shouta-31/WRO-Tezukayama-Lemon/flow_chart/Flowchart 8.PNG

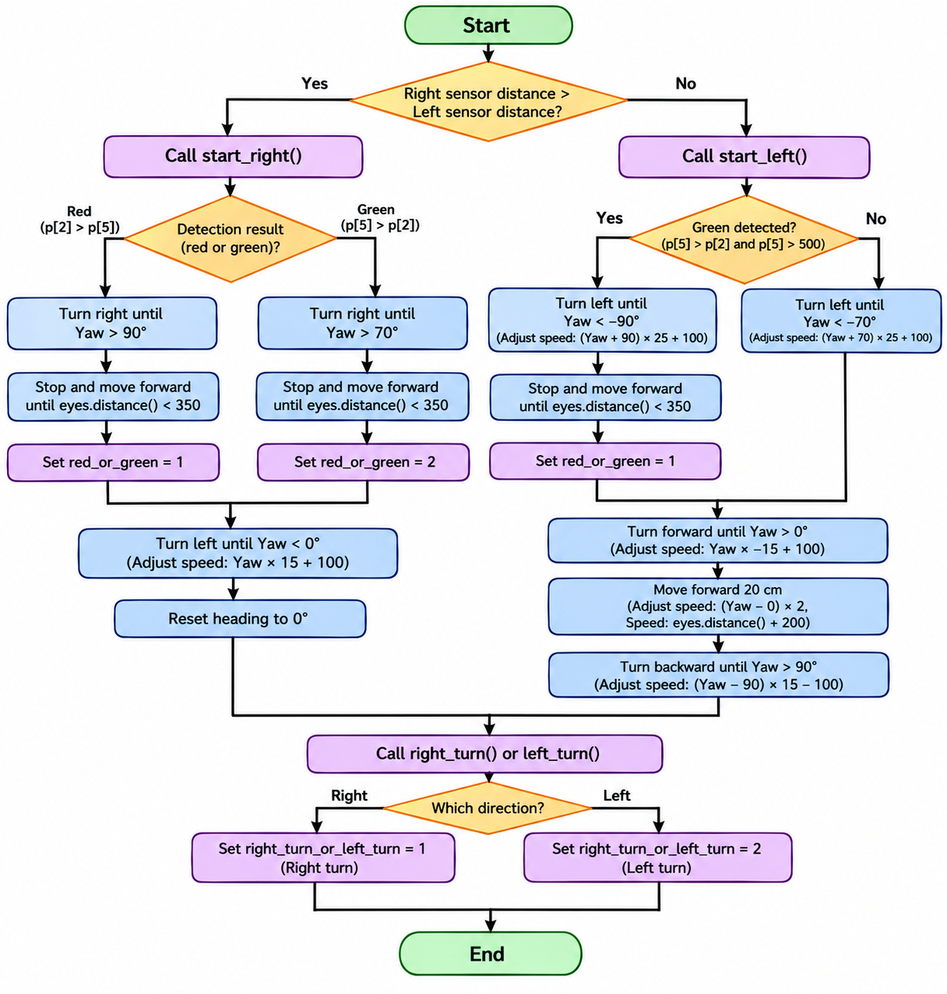
flow_chart/Flowchart 8.PNG
