shouta-31/WRO-Tezukayama-Lemon/flow_chart/Flowchart 7.PNG

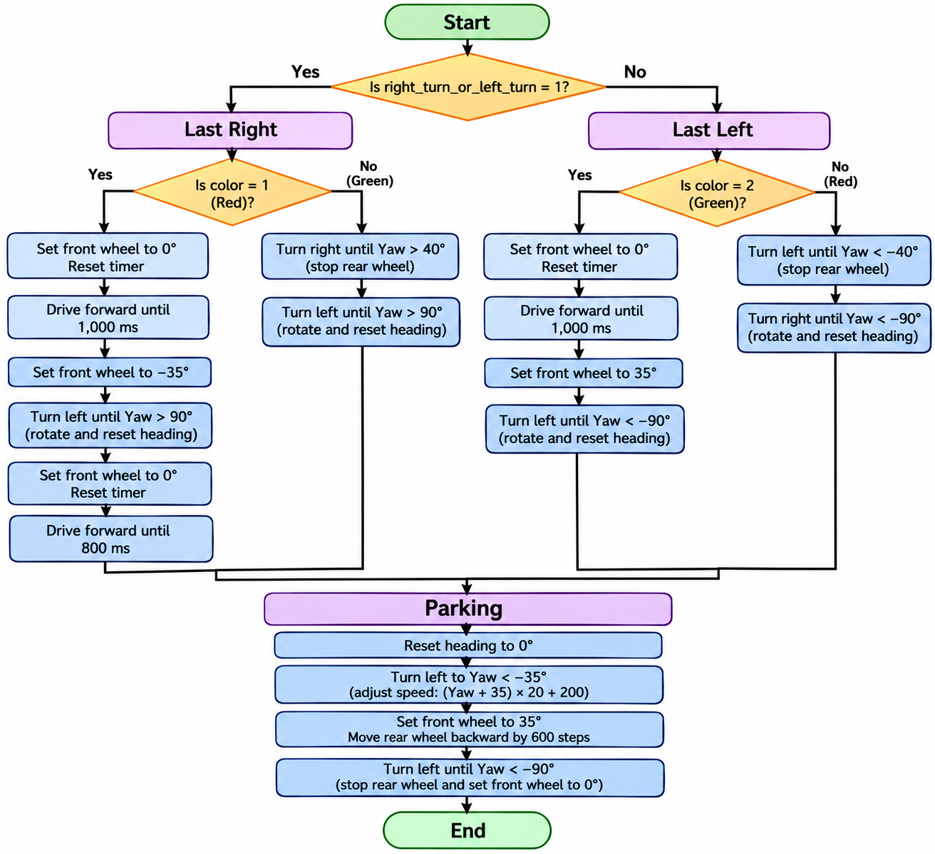
flow_chart/Flowchart 7.PNG
