shouta-31/WRO-Tezukayama-Lemon/flow_chart/readme.md

ロボット制御プログラムのフローチャート

flowchart_english_no_n

flowchart_english

ロボット駐車制御フローチャート

緑色障害物回避ロボット制御フロー図

赤色障害物回避フローチャート

ロボット制御ルーチンのフローチャート

ロボット旋回判断フローチャート
