shouta-31/WRO-Tezukayama-Lemon/schemes/Schematic.md

# Electromechanical diagrams 
## Overall Robot Circuit Diagram


## SPIKE Prime Hub Circuit Diagram


## OpenMV H7 Plus Circuit Diagram


## OpenMV H7 Plus OV5640 Circuit Diagram 
