shouta-31/WRO-Tezukayama-Lemon/t-photos/team's-photos.md

# Team's photos

## Funny Photo


## Official Photo
