shouta-31/WRO-Tezukayama-Lemon/v-photos/vehicle's-photos.md

# Vehicle's photos
## Front


## Rear side


## Left side


## Right side


## Top surface


## Bottom surface
