shouta-31/WRO-Tezukayama-Lemon/source/program.md

Control software
====
[Open rounds.pdf](https://github.com/user-attachments/files/30932936/Open.rounds.pdf)
[Open MV.pdf](https://github.com/user-attachments/files/30932932/Open.MV.pdf)
[Obstacle rounds.pdf](https://github.com/user-attachments/files/30932923/Obstacle.rounds.pdf)
