shouta-31/WRO-Tezukayama-Lemon/schemes/無題のドキュメント 2.pdf

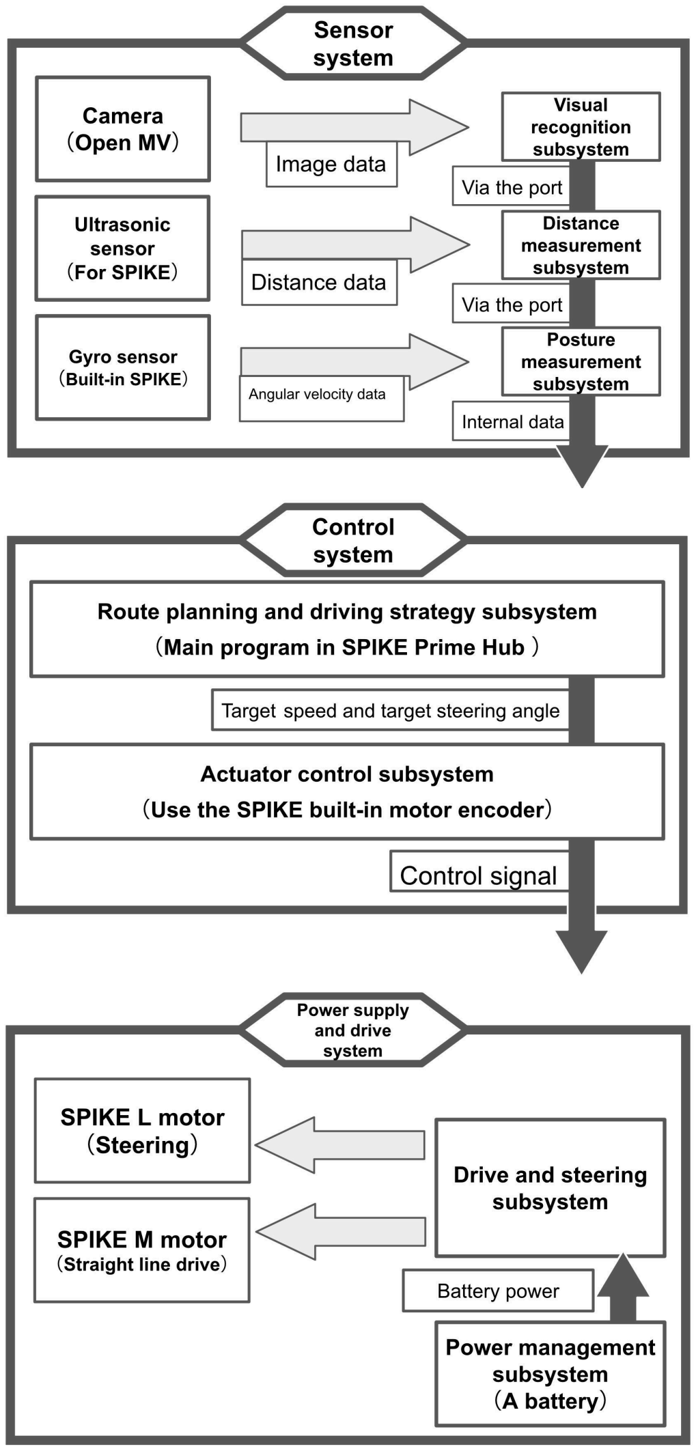
[picture p3: page 1]
