shouta-31/WRO-Tezukayama-Lemon/flow_chart/Flowchart 1.PNG

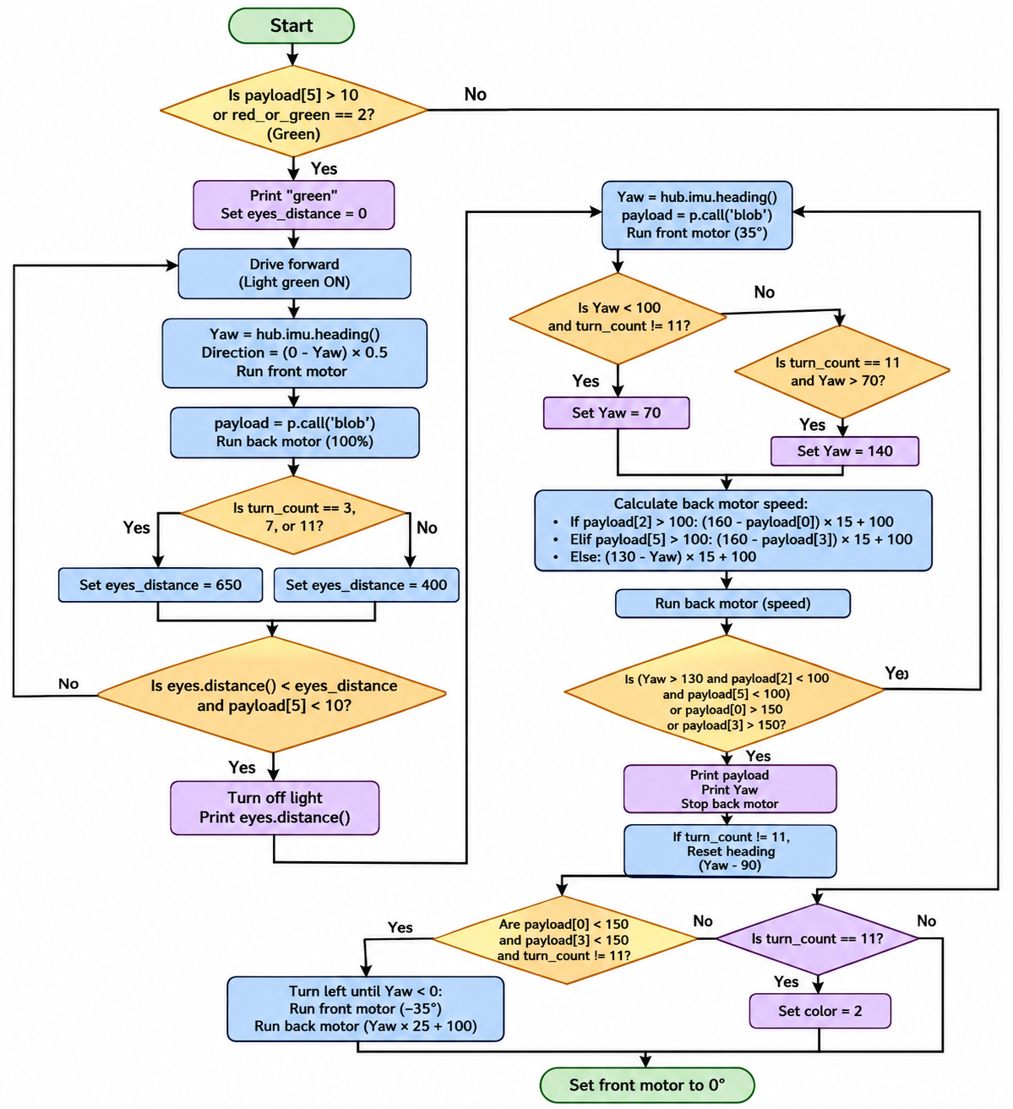
flow_chart/Flowchart 1.PNG
