shouta-31/WRO-Tezukayama-Lemon/flow_chart/Flowchart 2.PNG

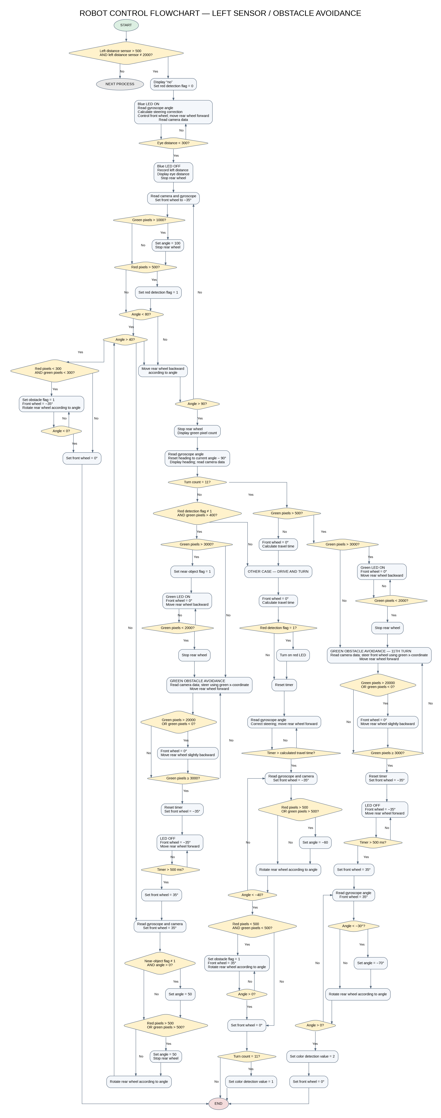
flow_chart/Flowchart 2.PNG
