shouta-31/WRO-Tezukayama-Lemon/flow_chart/Flowchart 3.PNG

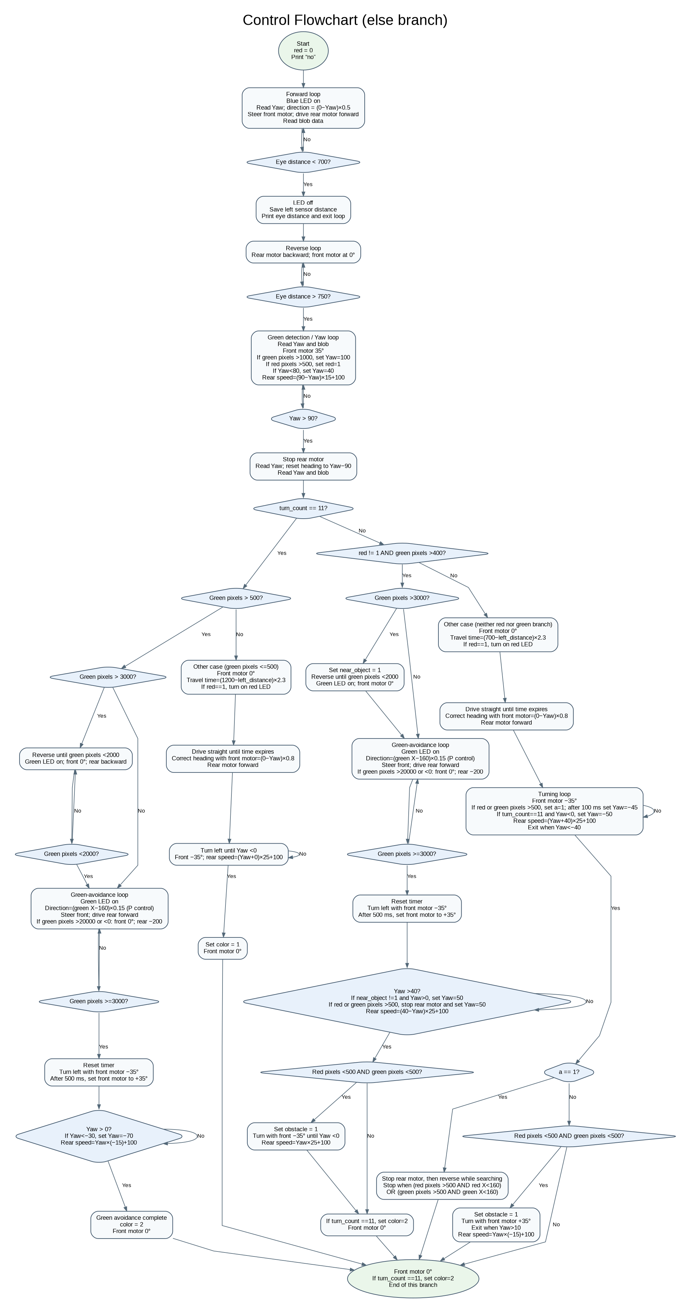
flow_chart/Flowchart 3.PNG
