shouta-31/WRO-Tezukayama-Lemon/flow_chart/Flowchart 4.PNG

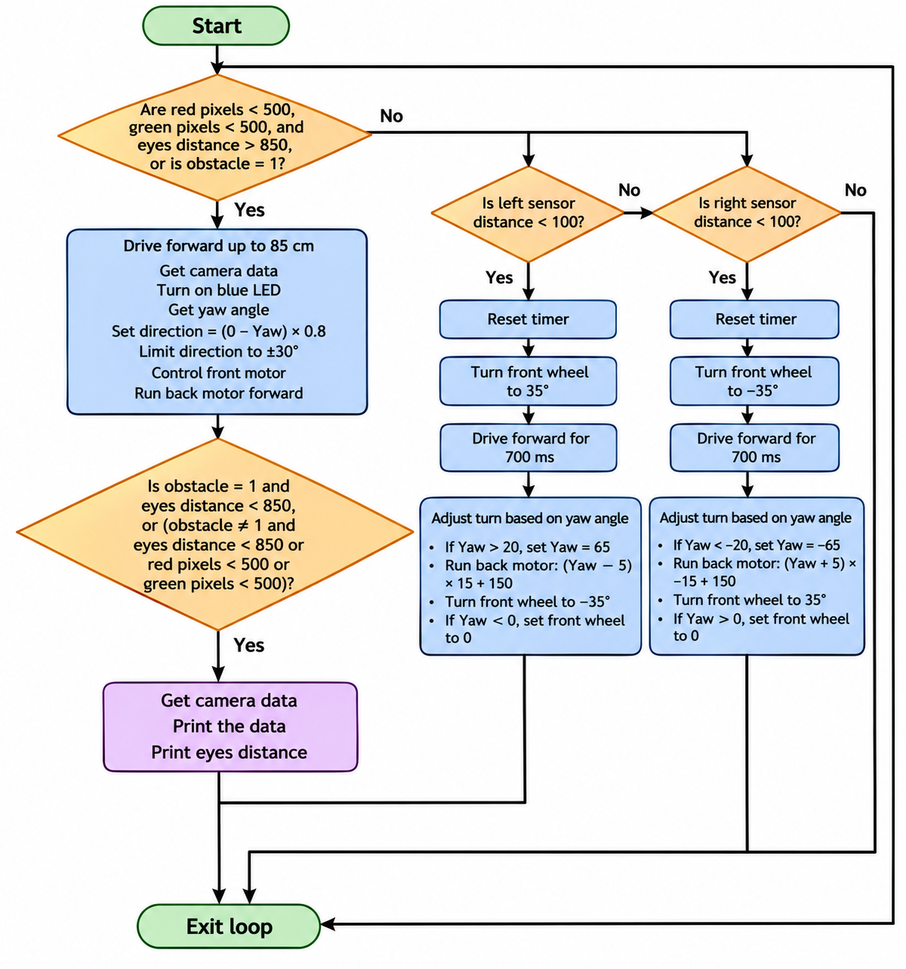
flow_chart/Flowchart 4.PNG
