shouta-31/WRO-Tezukayama-Lemon/flow_chart/Flowchart 5.PNG

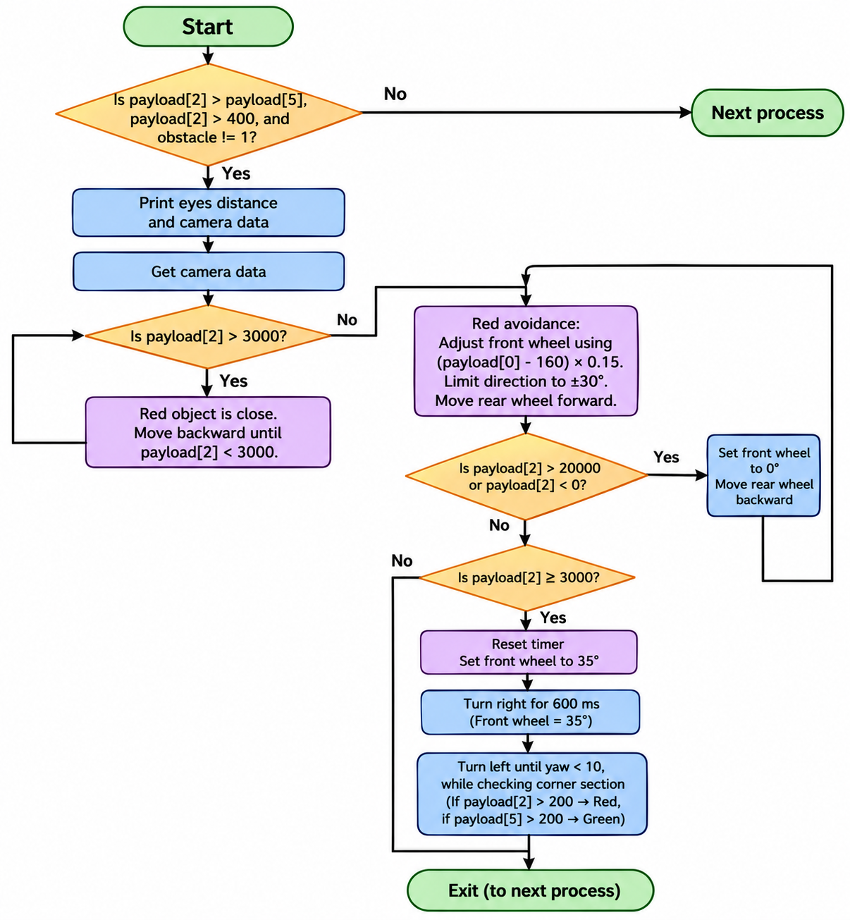
flow_chart/Flowchart 5.PNG
