shouta-31/WRO-Tezukayama-Lemon/flow_chart/Flowchart 6.PNG

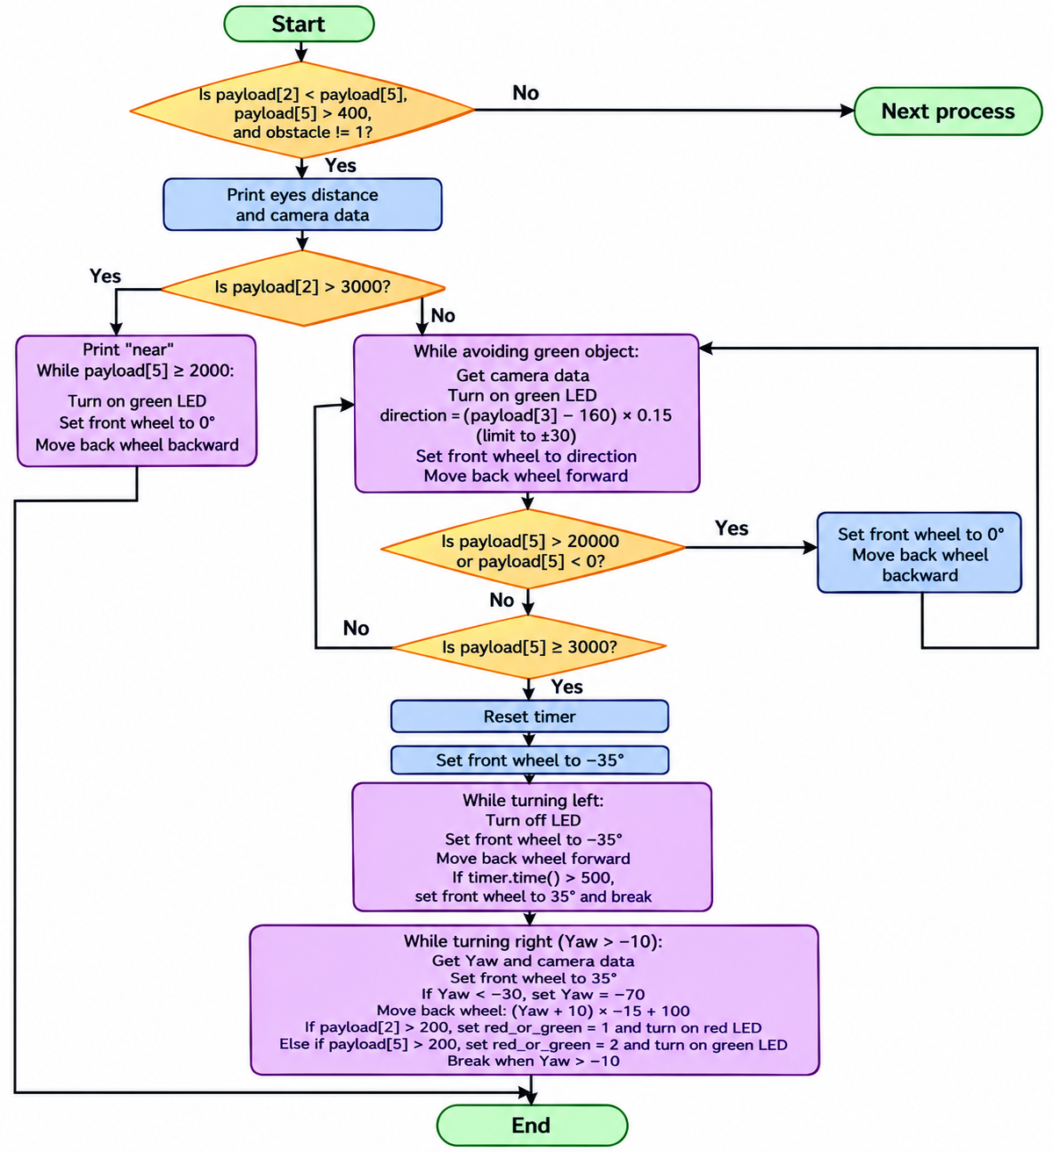
flow_chart/Flowchart 6.PNG
