shouta-31/WRO-Tezukayama-Lemon/models/OpenMV H7 Plus.stl

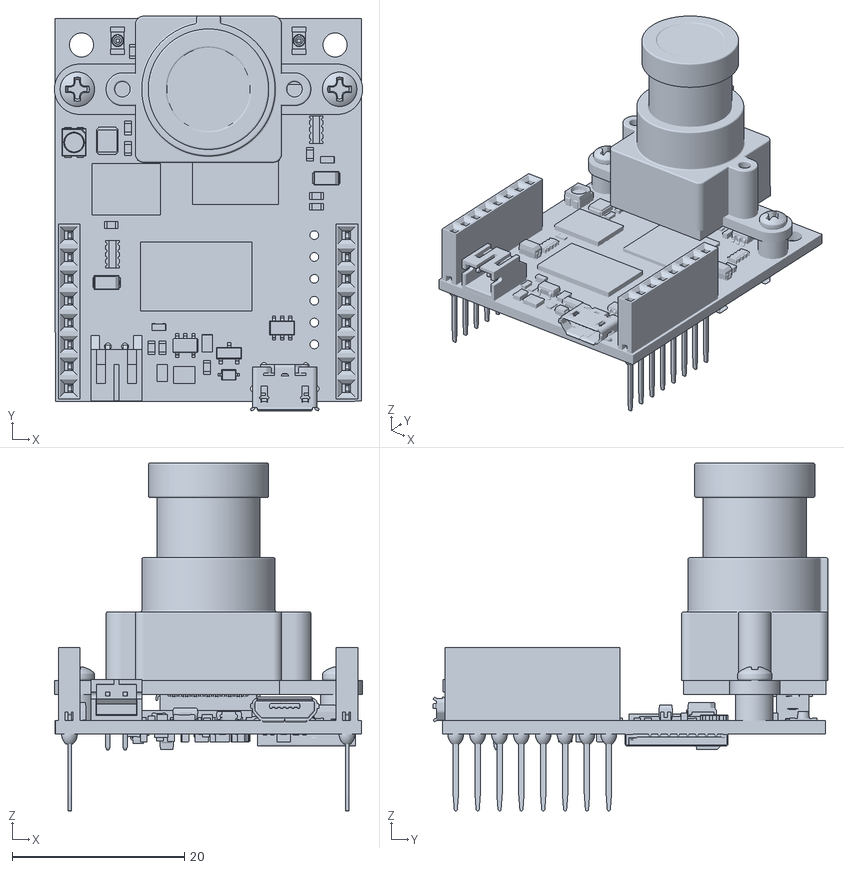
[picture p10: CAD file, 2026-10-02]
models/OpenMV H7 Plus.stl
35.8 x 45.9 x 40.4
