shouta-31/WRO-Tezukayama-Lemon/models/3D model platform.stl

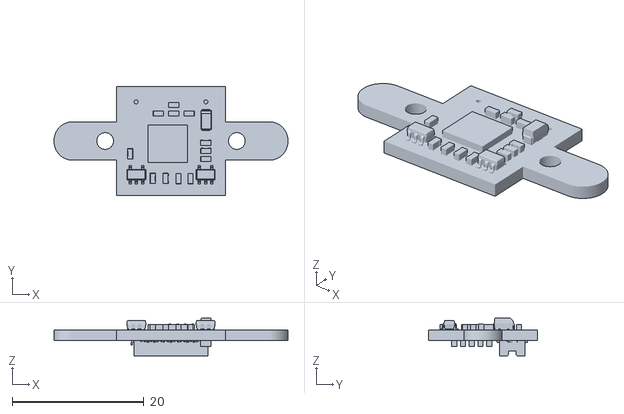
[picture p11: CAD file, 2026-10-02]
models/3D model platform.stl
35.6 x 16.5 x 5.70
