shouta-31/WRO-Tezukayama-Lemon/models/How to use the Robot 3Dmodel.ldr file.md

* First, download **"[Studio 2.0](https://store.bricklink.com/v2/studio/download.page)"**.

* Next, download the **"[3Dmodel.ldr](https://github.com/shouta-31/WRO-Tezukayama-Lemon/blob/main/models/Robot%203Dmodel.ldr)"** file. 
<br>

* Please click "Create new" at the top left.  
スクリーンショット 2026-10-06 204651. 
<br>

* Please click "File" in the top-left corner.  
スクリーンショット 2026-10-06 205957. 
<br>

* Please click "Open…" the second option from the top.  
スクリーンショット 2026-10-06 205929. 

* Please click on "3Dmodel.ldr" inside the folder.
