shouta-31/WRO-Tezukayama-Lemon/Engineering Journal/4_Systems Thinking.md

# 4:Systems Thinking
## 4.1:Interactions Between Subsystems

   



　　　　　　　　　　　　　　　　　［Subsystem Diagram］

To make it easier to identify where changes would have an impact when redesigning our robot’s subsystems, we created a subsystem diagram illustrating the interrelationships among the drive, sensor, power supply, and processing components mentioned above. From this diagram, we realized that the sensor system utilized various subsystems, so we decided to use OpenMV to reduce the number of lines of code within the camera in order to minimize program execution time as much as possible. In addition, this reduced the load on the Spike Hub and improved the control cycle. (See Section [3.1.2](https://github.com/shouta-31/WRO-Tezukayama-Lemon/blob/main/Engineering%20Journal/3_Program.md#312about-openmv)) for details.)  

Furthermore, this diagram allows others to easily understand the interrelationships and interactions among our robot’s subsystems at a glance.  

## 4.2:Vehicle Restrictions
Because the weight limit at the competition was 1.5 kg, the number of things on the robot was limited. Although the robot originally made did not exceed the restrictions, it weighed 689.2g. Therefore, the time to capture was limited, but it was a little longer. Therefore, by reducing the number of parts used for fixing by lowering the height of the robot, the weight of the robot can be 650.8g, and the capture time can be reduced by an average of 15 seconds, making it possible to capture quickly and accurately. I did.

## 4.3:Risk Identification and Mitigation Measures

　　　　　　　　　[A place where everyone can check the corrections in Japanese]

By consistently identifying and analyzing these risks and ensuring that everyone is aware of them, we are able to improve the robots’ accuracy. In addition, by working together to tackle problems that are difficult to solve through programming, we are reducing the burden on programmers.
