shouta-31/WRO-Tezukayama-Lemon/Engineering Journal/1_Strategy.md

# 1:Strategy
 To tackle the Open Challenge and Obstacle Challenge rounds, we devised specific strategies for each and built our robots and programs accordingly. We will now explain these strategies.
## 1.1:Open challenge rounds


 For the Open Challenge rounds, we programmed a strategy aiming for a lap time of 35 seconds: driving at maximum speed on straight sections and decelerating when approaching corners.
 
 We also modularized the movements into functions, enabling rapid parameter adjustments during the tuning phase. Furthermore, we implemented a deceleration routine for 90-degree turns using the gyro sensor, thereby minimizing positional errors that occur after navigating corner sections. Based on this strategy, the robot operates according to the state transition diagram shown below.  
 (For details of the program, see section [3.3](https://github.com/shouta-31/WRO-Tezukayama-Lemon/blob/main/Engineering%20Journal/3_Program.md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).)

. 

## 1.2:Obstacle challenge rounds
　The strategy for the Obstacle Challenge rounds of this tournament is primarily based on the Open Challenge rounds.oundsIt is based on the following. Also, the goal is1 week 30 secondsI created the program with that goal in mind.
Also, as a strategy, in the parking lotChoosing a parking spotI did that. I will proceed with departing from the parking lot. However, regarding parking, initially I was focused on accuracy and didn't have much time to dedicate to it. Therefore, I focused all my efforts on maximizing the accuracy of other missions. However, ultimately, both accuracy improved and I was able to allocate sufficient time for parking, so I decided to proceed with parking. Also,Obstacle detection logicIt operates according to the following state transition diagram.For details about the program, see section [3.4](https://github.com/shouta-31/WRO-Tezukayama-Lemon/blob/main/Engineering%20Journal/3_Program.md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).)

　　　　　　　　　　　　　　　　　　
                   　　　　　　　State machine diagram

## 1.3:Testing, Tuning, and Trade-offs
To complete the mission more accurately, we consistently aimed to score at least 80% on each challenge and repeatedly ran test workflows such as experiments to measure the distance between the robot and objects to fine-tune our system (see Section 3.4.1 for details). We also made trade-offs regarding parts and programming based on these tests.
 
The table below shows the scores achieved within the time limit during the Open Challenge rounds (open) and Obstacle Challenge rounds (obstacle) across 10 test runs.
