shouta-31/WRO-Tezukayama-Lemon/(commit log)

2026-09-12 Create strategy.md
2026-09-14 Create robot assembly book
2026-09-14 Create Robot materials.md
2026-09-14 Rename Robot materials.md to 2.1:Robot materials.md
2026-09-14 Update 2.1:Robot materials.md
2026-09-14 schemes.md を更新
2026-09-14 2.1:Robot materials.md を更新
2026-09-14 Update robot materials description and add 3D model reference
    Revised the explanation of robot materials and added information about the 3D model.
2026-09-14 Update Robot materials.md with 3D model information
    Added a note about the 3D model serving as a blueprint for replication.
2026-09-14 Enhance robot materials documentation with 3D model info
    Added a description of the 3D model as a blueprint for replication.
2026-09-14 Enhance robot materials documentation with 3D model details
    Added information about the 3D model of the robot as a blueprint.
2026-09-15 Update and rename Robot assembly book.pdf to Robot assembly book.pdf
2026-09-15 Update Robot assembly book.pdf
2026-09-17 Update robot design document with power and motor details
    Added details about power balance and motor specifications, including torque calculations and formulas.
2026-09-19 Adjust front wheel image and tire specifications
    Updated front wheel image size and clarified tire choice rationale.
2026-09-25 Fix formatting in Robot materials section
2026-09-28 Fix capitalization in robot assembly instructions link
2026-09-30 Enhance sensor section with additional images
    Added images for forward and left/right sensor sections to enhance visual understanding of sensor architecture.
2026-09-30 Create uartremote
2026-10-01 Update and rename uartremote to uartremote.md
2026-10-01 Update and rename uartremote.md to uartremote.py
2026-10-01 Update README to reflect two schematic diagrams
2026-10-01 Update robot design description for clarity
    Clarified the construction materials of the robot, emphasizing that it was built entirely from LEGO rather than 3D-printed parts due to accuracy issues.
2026-10-01 Update robot design document with resource links
    Added links to 3D model and assembly instructions for the robot.
2026-10-02 Rename Robot 3Dmodel.ldr to Robot 3Dmodel.stl
2026-10-03 README.md を更新
2026-10-05 Fix formatting in README.md for robot assembly section
2026-10-10 Create Schematic
2026-10-10 Rename 無題のドキュメント 2.pdf to Subsystem Diagram
2026-10-10 Rename 無題のドキュメント 2.pdf to Subsystem Diagram.pdf
2026-10-22 Enhance README with power supply comparison table
    Added a comparison table for power supply options including SPIKE Prime Hub, Raspberry PI, and EV3.
2026-10-22 Add electricity consumption and memory capacity details
2026-10-22 Add sensors and sensor architecture section to README
    Added a new section on sensors and sensor architecture with details on function and sampling rate.
2026-10-27 Enhance torque formula explanation in README
    Added definitions for variables in the torque formula.
2026-11-09 Fix LaTeX formatting for torque equations in README
2026-11-09 Add reference materials to README
